CRodriguezEE/electronics-project/measurements/final_bench_setup_12v.jpeg.jpeg

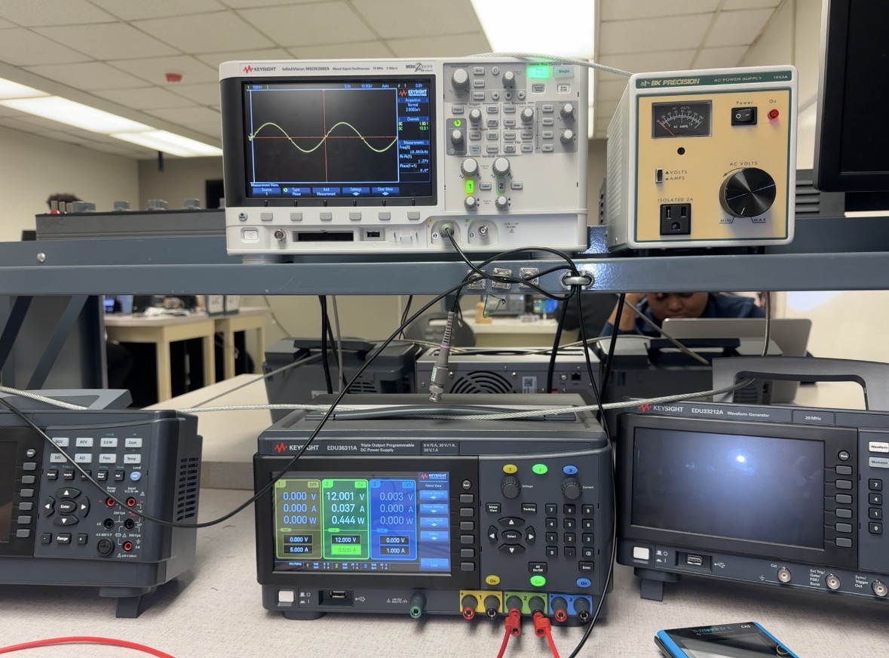
measurements/final_bench_setup_12v.jpeg.jpeg
