CRodriguezEE/electronics-project/measurements/spwm_frequency_16_97khz.jpeg.jpeg

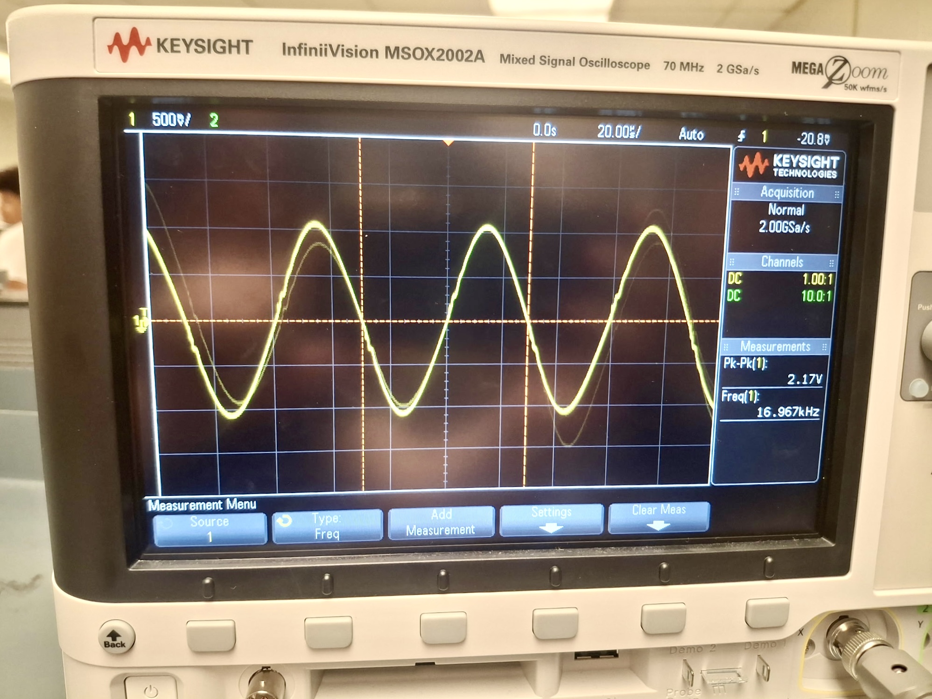
measurements/spwm_frequency_16_97khz.jpeg.jpeg
