CRodriguezEE/electronics-project/images/circuit_map_breadboard.jpeg

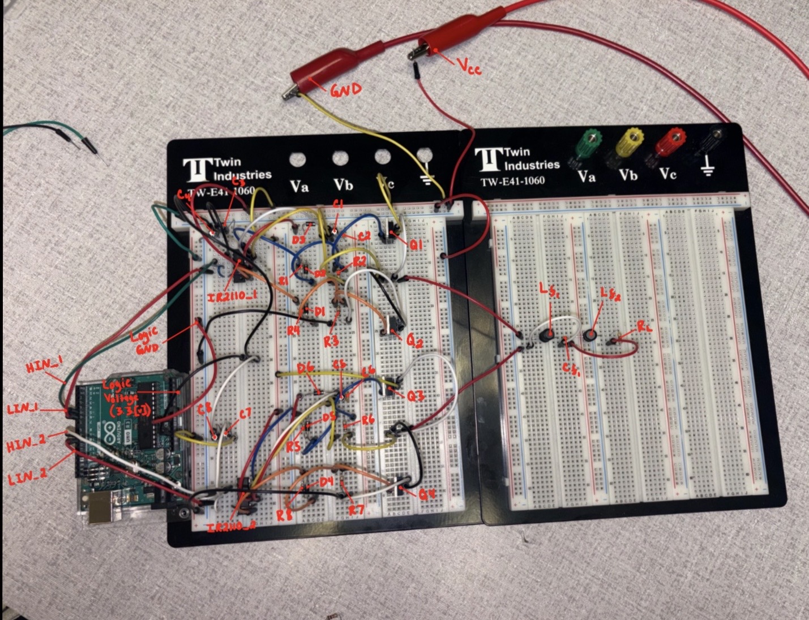
images/circuit_map_breadboard.jpeg
