CRodriguezEE/electronics-project/images/system_overview_diagram.jpeg

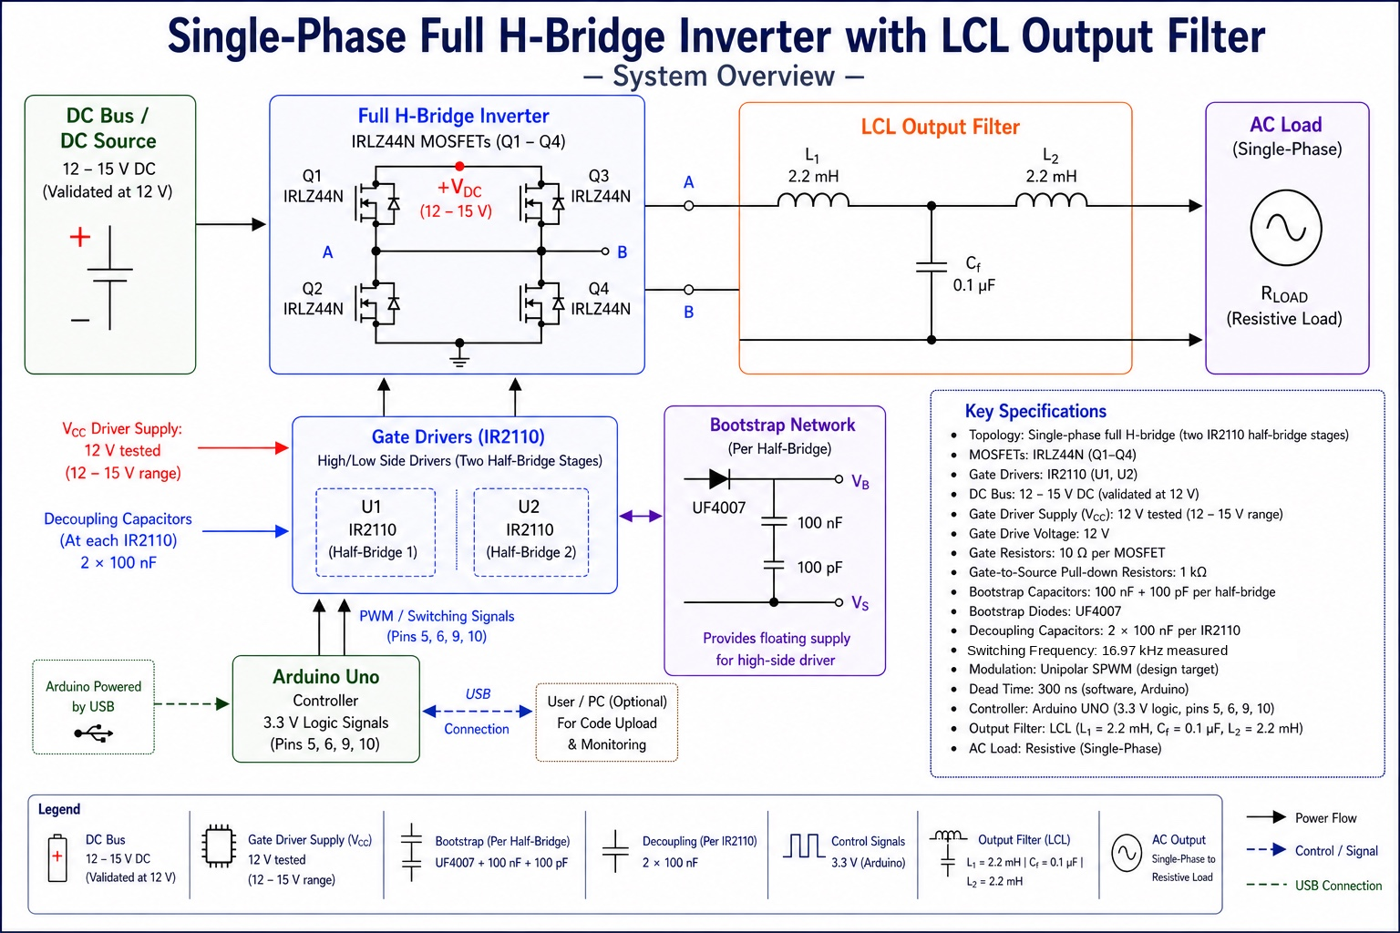
images/system_overview_diagram.jpeg
