CRodriguezEE/electronics-project/schematics/inverter_full_schematic_RD.jpeg

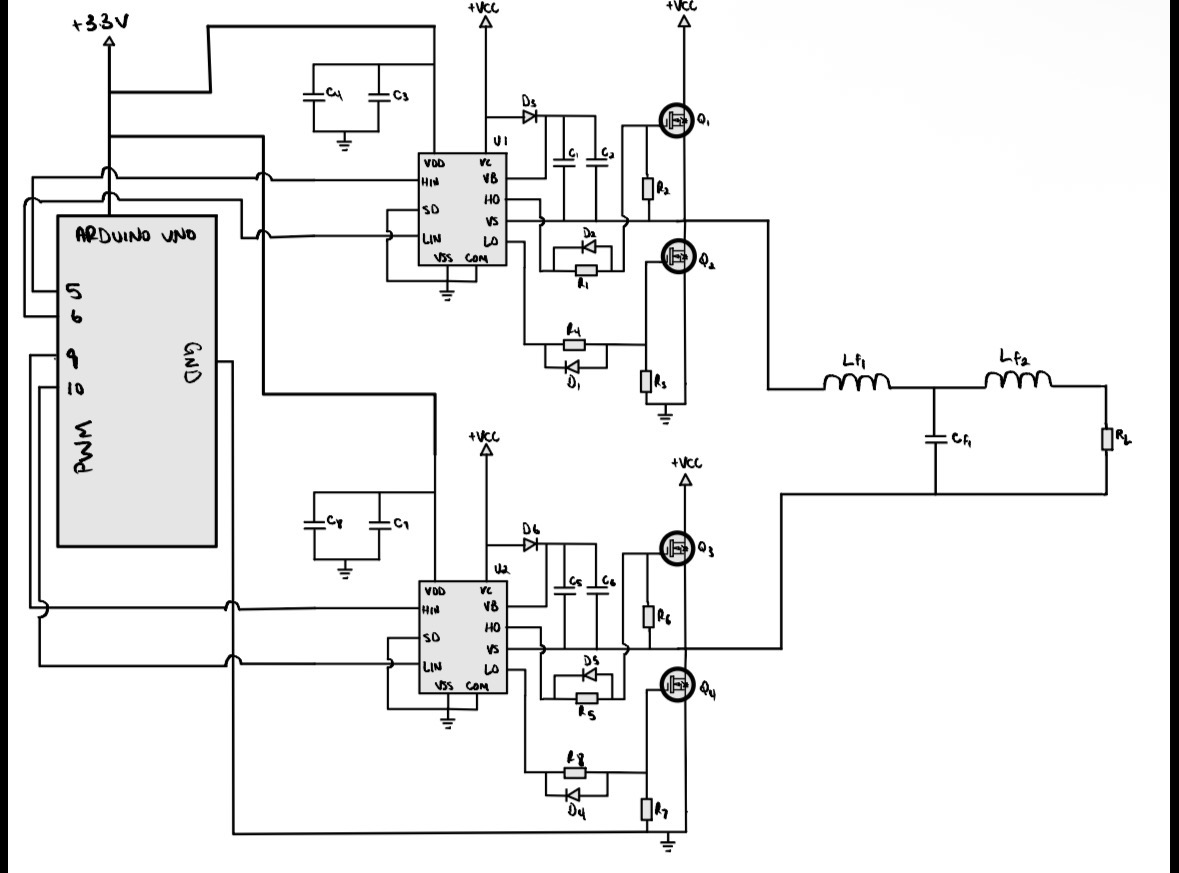
schematics/inverter_full_schematic_RD.jpeg
