CRodriguezEE/electronics-project/(commit log)

2026-04-09 Create schematics
    Posted schematic diagrams.
2026-04-09 Set up folder structure for schematics, calculations, and measurements
2026-05-22 Add inverter test summary and validation checklist
    - Added verified and observed inverter test results
    - Documented unresolved measurements and next validation steps
    - Clarified gate-drive, bootstrap, grounding, and PWM configuration issues
2026-05-22 Add LCL filter design calculation
2026-05-22 Add Inverter Full Schematic
2026-05-22 Add circuit map image
2026-05-22 Add test firmware
    Add Arduino code for H-bridge switching test
